bgautrea/coin_sorter/hardware/coin_hat/README.md

# Coin sorter HAT+ — rev 1

KiCad project for a Pi 5 HAT+ that carries the whole motion side of the
sorter: 12 V in, buck to 5 V for the Pi, a Raspberry Pi Pico, two StepStick
sockets (TMC2209 or A4988, selected by solder jumpers) for belt and feeder, the
MG996R diverter servo on its own buck, switched 12 V outputs, and the small
stuff (LED ring level shifter, feeder home switch, coin sensor, HAT+ ID EEPROM).

The board runs **lengthwise** along the Pi: 122 × 56.5 mm, the same width as the
Pi. The HAT+ holes and header sit at one end, and a 57 mm overhang runs past the
Pi's SD-card / PCIe end, so the drivers, jack and bucks sit over nothing. The
Pi + HAT stack is 142 × 56.5 mm, a slim box instead of rev 0's 85 × 90. The
overhang goes off the SD end, not the USB end: at 16 mm spacer height, a board
over the USB/Ethernet jacks would sit on top of the plugs.

Generated by a script, so it is a *netlist with symbols placed on a sheet*, not
a drawn schematic: every pin carries a global label and the parts are grouped by
function. Redraw with wires or leave it — KiCad is happy either way.

## Rev 1 changes (2026-09-27)

- **Diverter is the MG996R servo, not a stepper.** U4 socket, its jumpers
  JP41–44, the 4-pin motor connector and C5 are gone, and so is the diverter
  home switch (J8), because the servo is absolute. New parts: U8 is a separate
  12 V → 5–6 V buck just for the servo (+SERVO). J4 is a 3-pin 0.1" servo
  header (1 SIG, 2 V+, 3 GND). C6 is 1000 µF placed *at* J4. D5 lights when the
  servo rail is live, and GP27 reads the servo rail through a 10k/10k divider.
  GP6 drives the signal pin directly, with no series resistor and no pulldown.
  That is how the bench build works.
- **Why the LED and the sense line:** if the servo rail is dead and GP6 is
  pulsing, the servo back-powers through its signal pin. It twitches and never
  moves, which looks exactly like a signal fault. Check D5 (or GP27) first.
- **Outline goes lengthwise** (see above), with the **CSI/DSI FPC notch**
  (10 × 16.5 mm on the bottom edge, per the HAT+ spec's M.2 HAT+ drawing). Rev 0
  had no notch and would have blocked the camera cable.
- **Header position fixed.** Rev 0 had it 1.27 mm off in both axes. HAT+ spec:
  the header centre is 29 mm from the left hole, on the hole line, so pin 1 is
  at (8.37, 4.77) from the Pi corner and pin 2 is at (8.37, 2.23).
- **Diode polarity fixed.** KiCad diode and LED footprints put the cathode on
  pad 1, and rev 0's symbols had the anode on pin 1. D3/D4 flybacks would have
  shorted 12 V to ground when the key light or aux output switched on, D1
  would have blocked the Pico's VSYS, and D5 would never light.
- **StepStick pin numbering fixed.** Rev 0's symbol numbered pins 1 = EN …
  16 = GND. The `Pololu_Breakout-16` footprint is 1 = GND, 2 = VDD, 3–6 = motor,
  7 = GND, 8 = VMOT, 9 = EN … 16 = DIR, so every driver pin would have landed
  on the wrong pad.
- **Verified with KiCad 9:** ERC shows 0 errors (the remaining warnings are
  off-grid pins and the embedded `coin_hat` symbol library). Every symbol pin
  number exists as a pad on its footprint, and there are no single-node nets.
  DRC on the outline shows 0 violations. The floor plan on `User.Comments` is
  the real courtyards (buck modules as their 17.8 × 20.3 boards), checked for
  overlaps, holes, header and notch. 57 mm is the shortest overhang that packs
  cleanly; 52 mm clashes.

## Files

- `coin_hat.kicad_pro` / `coin_hat.kicad_sch` — open this. Symbols are embedded;
  footprints point at the stock KiCad 8 libraries. **Tools → Update PCB from
  Schematic** pulls all footprints into the board.
- `coin_hat.pretty/` + `fp-lib-table` — project footprint library with the
  two Pololu buck modules. Pad and mounting-hole positions come from Pololu's
  drill-guide DXFs (`reg15d01-drill.dxf` for the D24V50F5, `reg24g-drill.dxf`
  for the D36V28Fx), drawn top view with pad 1 = EN (square):
  - D24V50F5: one row EN, VIN, GND, GND, VOUT along a 0.7" edge.
  - D36V28Fx: the same row, plus PG 0.1" inboard of EN.
  - Both: #2 (2.2 mm) mounting holes in opposite corners.
  EN is left open on both (each module has a 100 kΩ pull-up to VIN), and PG
  is unused.
- `coin_hat.kicad_pcb` — placed and fully routed 2-layer board, 122 × 56.5 mm
  (see Routing).
- `make_fab.py` — regenerates everything in `fab/` from the schematic and board
  (`python3 hardware/coin_hat/make_fab.py`).
- `fab/` — ready to upload (see Ordering).

## Pin map (Pico)

| Function | Pins | Notes |
|---|---|---|
| Pi link | GP0 TX / GP1 RX (UART0) | Pi GPIO14/15, `/dev/ttyAMA0`, `dtparam=uart0=on`. REPL stays on USB. |
| Belt | STEP GP2, DIR GP3, EN GP4 | unchanged from `firmware/main.py`; TMC UART addr 0 |
| Diverter servo | GP6 → J4 signal | unchanged from `firmware/main.py`; direct, no resistors |
| Servo rail sense | GP27 (ADC1) | 10k / 10k: 5.4 V → 2.7 V, 6 V → 3.0 V |
| Feeder | STEP GP18, DIR GP19, EN GP22 | TMC UART addr 1 |
| TMC UART | GP20 TX via 1 k, GP21 RX | single-wire bus shared by both drivers |
| Feeder home | GP11 | to GND, internal pull-up |
| Coin sensor | GP5 | 3-pin XH |
| Key light / aux MOSFET | GP14 / GP15 | AO3400, flyback diode, 2-pin terminals |
| LED ring | GP16 → 74AHCT1G125 → 5 V data | 3-pin XH |
| VMOT sense | GP28 | 100 k / 15 k: 12 V → 1.57 V |
| Aux header | GP7, GP9, GP17, GP12/13 (I²C), GP26 (ADC0) | plus 3V3/GND |
| Spare | GP8, GP10 | no-connect |

The Pi resets the Pico by driving **GPIO17 high**, which makes Q3 pull RUN low.
It is active-high on purpose: GPIO17 defaults to pull-down at boot, so an
unconfigured Pi leaves the Pico running. `pinctrl set 17 op dh; sleep 0.1;
pinctrl set 17 dl` replaces the USB DTR toggle that relaunches `main.py` today.

## Power

Jack → F1 (mini blade) → +12 V bus. The bus feeds:

- the StepSticks (100 µF each) and the switched outputs;
- U5 (12 → 5 V, 5 A module) → +5 V → Pi header pins 2/4, and Pico VSYS
  through D1;
- U8 (12 → 5–6 V, ~3 A module) → +SERVO → J4.

U5 is a Pololu D24V50F5. For U8, any D36V28Fx fits the same footprint: the F5 (5 V) or the F6 (6 V). The MG996R
is rated 4.8–7.2 V, and 6 V gives more torque than the 5.4 V bench supply.

Feeding a Pi 5 over the header skips USB-PD, so set `usb_max_current_enable=1`
if USB peripherals need more than 600 mA. Size F1 to the real load: Pi 5 up to
~2.3 A at 12 V, plus two steppers, plus the servo (1.4 A stall at 6 V ≈ 0.8 A
at 12 V).

## Mechanical

- 16 mm board-to-board spacers (HAT+ spec recommendation for the Active
  Cooler) and a matching stacking header. Keep the bottom side clear over
  the Pi (Pico zone) and over the Pi 5 PoE header, which is marked on the
  board.
- The Pi 5 PCIe FFC connector sits under the overhang near the Pi edge. It is
  unused here, and a flat cable would still pass under a 16 mm-high board.
- The motor connectors, fuse and jack are on the left end so a case can have
  one connector wall. J5 is a CUI PJ-102AH (5 A, 5.5 × 2.1 plug).
- Copper keepouts around the four HAT+ holes: 3.1 mm radius on the bottom,
  where the metal standoff sits (and is likely tied to the Pi's ground), and
  2.6 mm on top, under the screw head.

## Routing

Two layers, 1 oz, every net routed. KiCad 9 DRC: 0 violations, 0 unconnected,
0 schematic-parity issues.

| Net class | Nets | Track |
|---|---|---|
| HighCurrent | VIN_RAW, +12V, +5V | 1.5 mm |
| Power | +SERVO, VSYS_PICO, switched 12 V outputs | 1.0 mm |
| Motor | stepper coil nets | 0.6 mm |
| Ground | GND (the pours carry the current) | 0.35 mm |
| Default | signals | 0.25 mm / 0.2 mm space |

Signal vias are 0.6/0.3 mm. Power-net vias are 1.2/0.6 mm (about 3 A each),
except one 0.8/0.4 mm AUX_SW via in a tight spot, so rate J12 (aux 12 V out) at
about 1.5 A. GND is poured on both layers. Five GND pads connect solid to the
pour rather than through thermal spokes: U3.7, J10.2, J1.14, C6.2 and one Pico
GND pad. Give those a hotter iron.

Freerouting did the autorouting, except for the Pi 5 V feed, which is
hand-placed and locked. J1 pins 2/4 are boxed in by the mounting hole, the board
edge and the other header pins, so the feed runs 1.5 mm on F.Cu from U5 VOUT,
passes under the hole, and necks to 1.0 mm for the last ~3 mm beside pin 1.
Official HAT+ boards squeeze through the same gap.

The Pico sits with its USB socket at the board's right edge, so a micro-USB
cable plugs in for REPL and `mpremote`. The HAT+ ID EEPROM group (U7,
R10–R12, JP1, C8) sits in the pocket left of the Pico. U6 and U7 each have a
100 nF bypass cap (C7, C8).

Silkscreen: labels for JLCPCB-placed parts are on F.Fab only (the placement
file carries them). JP21/22/23 and JP32/33 had no room for a readable label, so
read the jumper columns top to bottom: JP21→JP24 beside U2 (belt) and JP31→JP34
beside U3 (feeder). JP24, JP31 and JP34 are labelled, and the 2-pad MS1/MS2
jumpers sit above the 3-pad ones.

## Ordering

Everything is in `fab/`:

- `coin_hat_gerbers.zip` — Gerbers + Excellon drill (separate PTH/NPTH). Both
  fabs take it. Specs: 2 layers, 122 × 56.5 mm, 1.6 mm FR-4, 1 oz, smallest
  drill 0.3 mm, track/space 0.25/0.2 mm. Standard capabilities at both.
- **JLCPCB** — `jlcpcb/coin_hat_bom_jlcpcb.csv` + `jlcpcb/coin_hat_cpl_jlcpcb.csv`.
  Assembly: top side only, 25 placements, 12 unique parts. All resistors,
  the AO3400A and the SS34 are Basic parts. The SMBJ15A is "preferred
  extended" (no setup fee). The level shifter, EEPROM and LED are Extended
  (JLC's per-part loading fee).
- **PCBWay** — `pcbway/coin_hat_bom_pcbway.csv` (every part, with through-hole
  lines marked "customer solders") + `pcbway/coin_hat_centroid_pcbway.csv`.

Check before you pay:

- **JLCPCB's placement preview.** KiCad and JLC orient some packages
  differently. The CPL applies the usual corrections (SOT-23 / SC-70 +180°,
  SOIC +270°), but check every part, and especially the cathode bars on
  D1–D4 and the LED.
- U1 (Pico) and the solder jumpers are deliberately left out of assembly. The
  Pico's pads have no paste, so the stencil leaves them bare. You solder the
  Pico by its castellations. KiCad DRC reports U1 as "differs from library"
  for that reason. That warning is expected.
- Hand-soldered: J1 is a 2×20, 2.54 mm female socket on the **bottom** side.
  It is not in the BOMs, and its height matters. With 16 mm spacers, the Pi's
  pins (8.5 mm tall) only engage a socket body of H mm by H − 7.5 mm, so a
  standard 8.5 mm socket barely touches. Use an 11–13 mm tall socket. The
  StepStick sockets are 2× 1×8 female headers per driver.
- Trim through-hole leads flush over the Pi (J6/J7/J9–J12). The Active Cooler
  sits under that area, and the HAT+ spec asks for extra clearance if the
  underside isn't flat.
- Power only through the 12 V jack while the HAT is fitted. U5 feeds the Pi's
  5 V rail directly, with nothing to stop backfeed if the Pi's USB-C is also
  plugged in. U5 also regulates to 5.0 V, not the 5.1 V the Pi's own supply
  gives. That's fine, but it leaves less headroom before the under-voltage
  warning if a heavy USB load is attached.

## Verify before ordering

- TMC2209 breakout pin order (the 16-pin socket varies between makers; DIAG /
  INDEX are often extra pins outside it).
- Solder jumpers per driver socket (JPx1–JPx4) match the driver you fit:
  **TMC2209** — JPx3=A (UART on pin 4), JPx4=A (CLK→GND), JPx1/JPx2 = UART
  address (belt 00, feeder 10). **A4988** — JPx3=B (MS3 high), JPx4=B (RESET
  tied to SLEEP), JPx1+JPx2 closed = 1/16 step; set Vref = I × 8 × Rsense
  (0.40 V for 0.5 A with R100 sense resistors); heatsink.
- Buck modules sit on 0.1" header pins in the `coin_hat:Pololu_*` footprints.
  Order the modules with their header strip, or use a low-profile socket.
- J4 pin order vs your servo plug (usual order: signal, V+, GND; brown wire =
  GND).
- Header, holes and FPC notch against the official Pi 5 mechanical drawing. The
  socket goes on the **bottom** side.
- Belt motor current rating (TMC2209 tops out around 2 A RMS).

## Firmware implications

The feeder moves to DIR/EN on GP19/GP22, and the Pi link moves from USB CDC to
UART0. Current and hold settings move from DIP switches to TMC UART writes. The
servo stays on GP6 exactly as `firmware/main.py` drives it today; optionally
read GP27 and refuse to pulse GP6 while the servo rail is down. None of this
changes the serial protocol the Pi speaks.
