bgautrea/coin_sorter/hardware/coin_hat/coin_hat.kicad_pcb

## KiCad design hardware/coin_hat/coin_hat.kicad_pcb (2026-09-27)

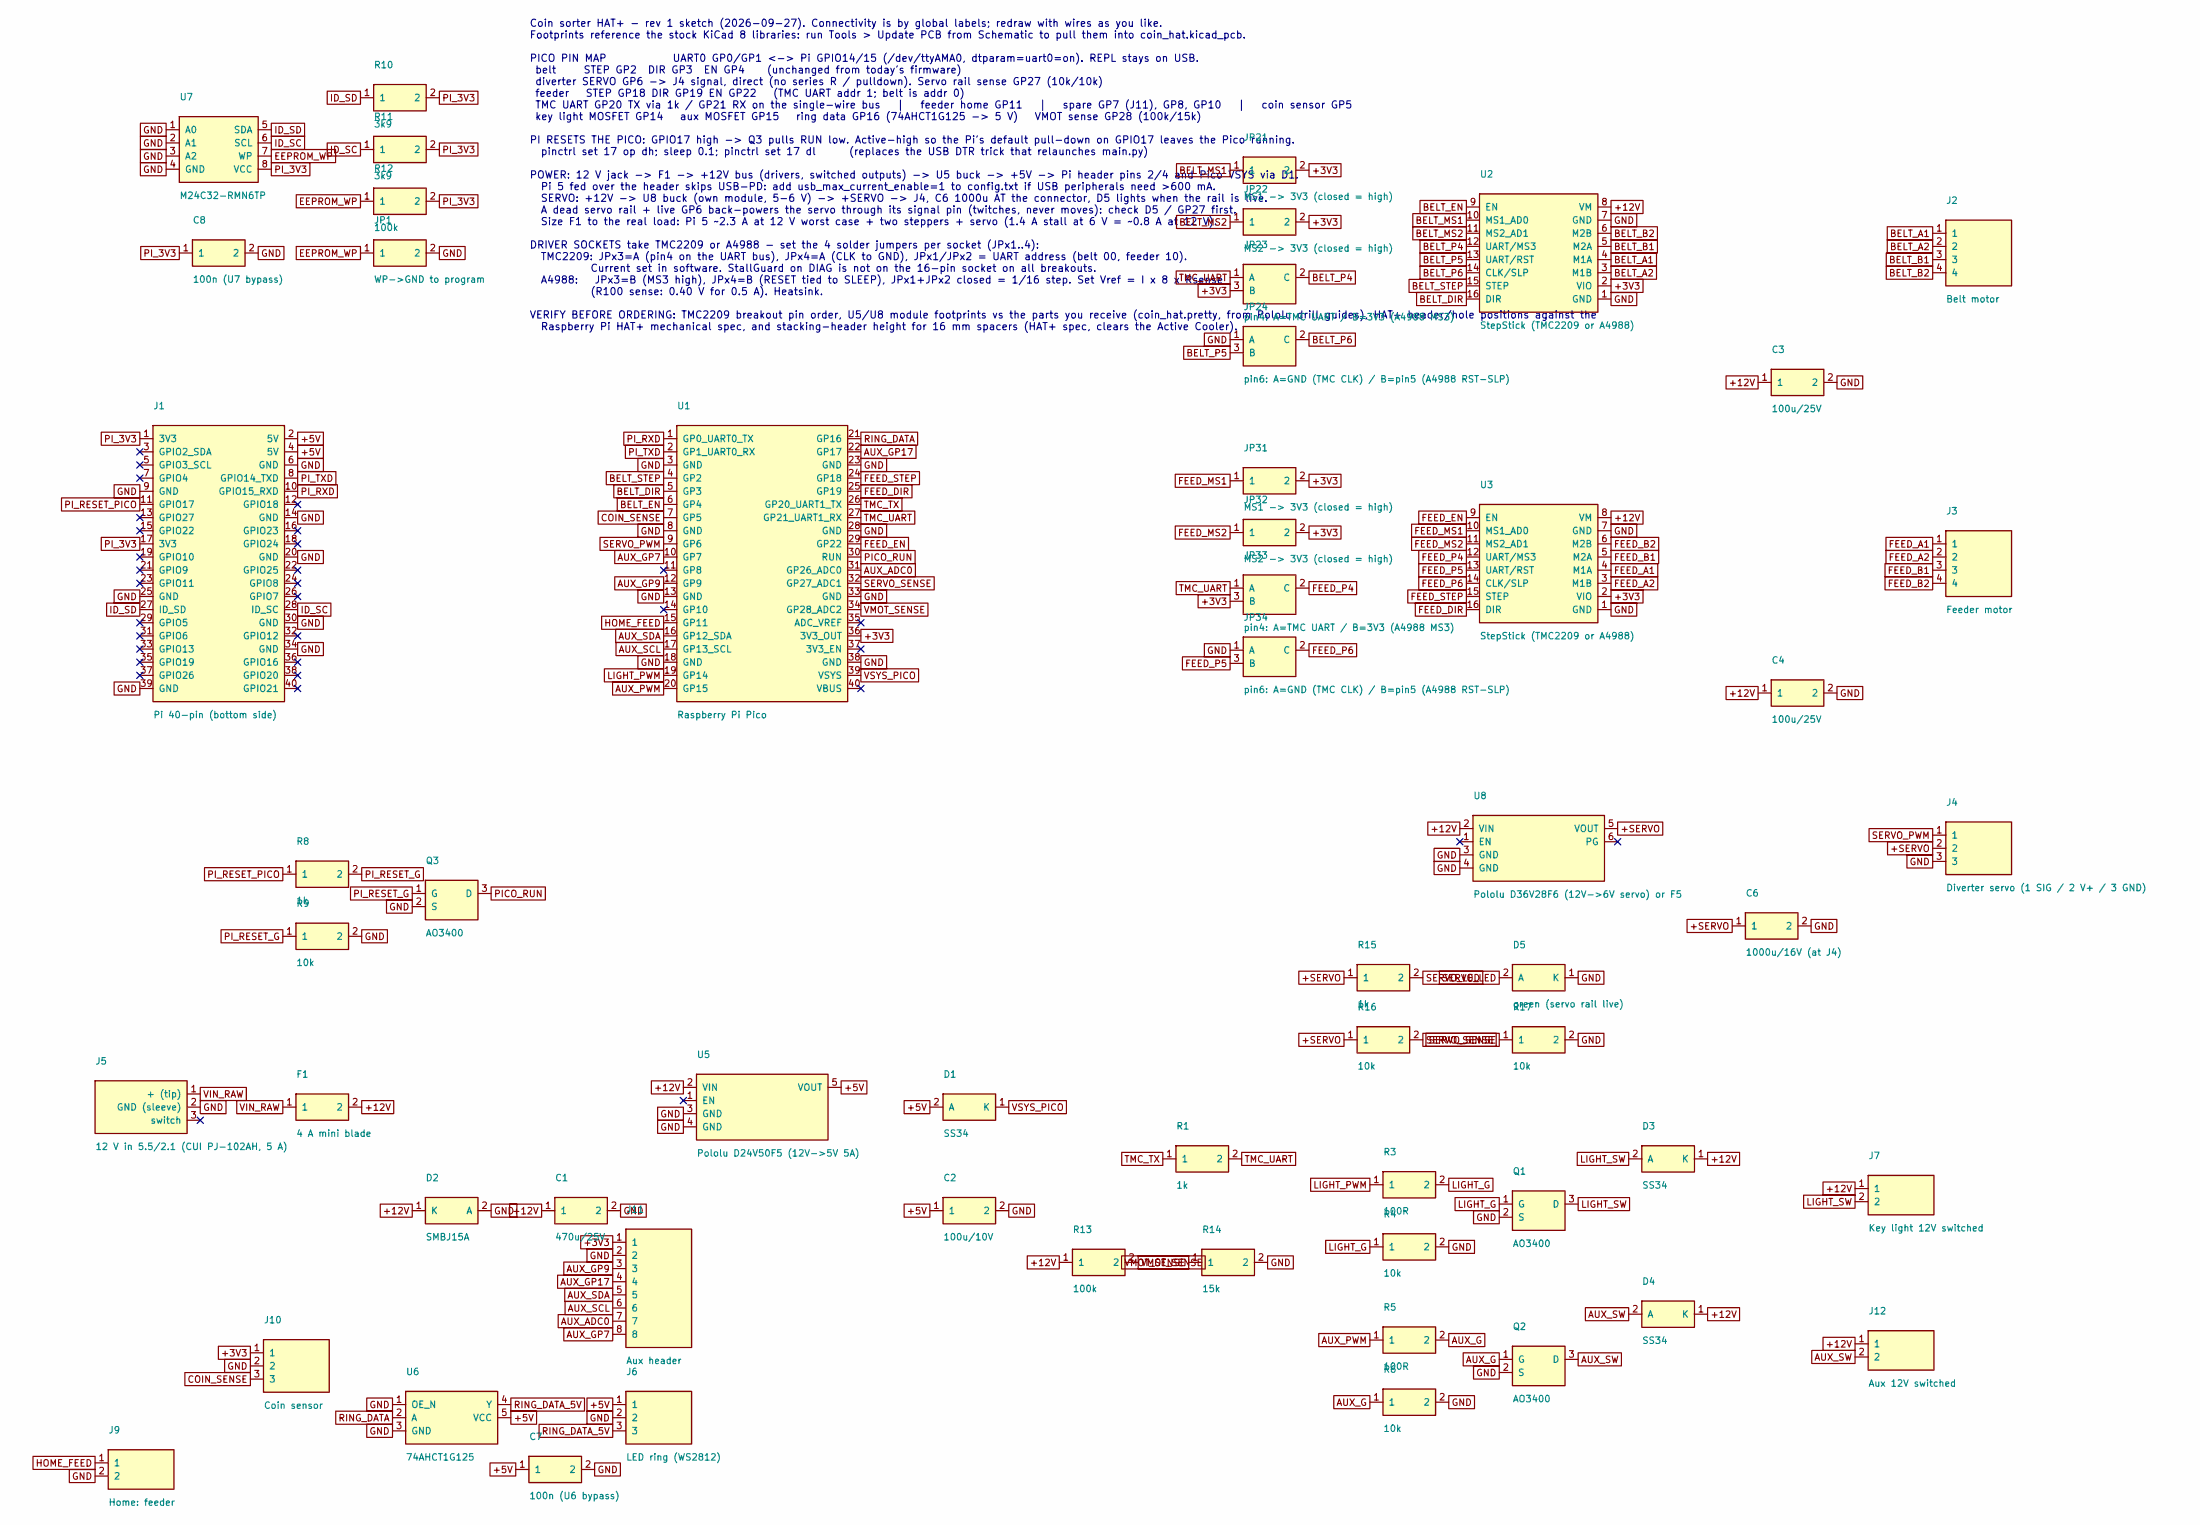
[picture p1: schematic coin_hat.kicad_sch, Coin sorter HAT+]

Parts:
C1: 470u/25V; CP_Radial_D10.0mm_P5.00mm
C2: 100u/10V; CP_Radial_D8.0mm_P3.50mm
C3, C4: 100u/25V; CP_Radial_D8.0mm_P3.50mm
C6: 1000u/16V (at J4); CP_Radial_D10.0mm_P5.00mm
C7: 100n (U6 bypass); C_0603_1608Metric; MPN CC0603KRX7R9BB104; LCSC C14663
C8: 100n (U7 bypass); C_0603_1608Metric; MPN CC0603KRX7R9BB104; LCSC C14663
D1, D3, D4: SS34; D_SMA; MPN SS34; LCSC C8678
D2: SMBJ15A; D_SMB; MPN SMBJ15A; LCSC C19077569
D5: green (servo rail live); LED_0603_1608Metric; MPN XL-1608UGC-04; LCSC C965804
F1: 4 A mini blade; Fuseholder_Blade_Mini_Keystone_3568; MPN 3568 holder + 4 A mini blade fuse
J1: Pi 40-pin (bottom side); PinSocket_2x20_P2.54mm_Vertical
J2: Belt motor; JST_XH_B4B-XH-A_1x04_P2.50mm_Vertical; MPN B4B-XH-A(LF)(SN); LCSC C144395
J3: Feeder motor; JST_XH_B4B-XH-A_1x04_P2.50mm_Vertical; MPN B4B-XH-A(LF)(SN); LCSC C144395
J4: Diverter servo (1 SIG / 2 V+ / 3 GND); PinHeader_1x03_P2.54mm_Vertical
J5: 12 V in 5.5/2.1 (CUI PJ-102AH, 5 A); BarrelJack_CUI_PJ-102AH_Horizontal; MPN PJ-102AH; LCSC C3096093
J6: LED ring (WS2812); JST_XH_B3B-XH-A_1x03_P2.50mm_Vertical; MPN B3B-XH-A(LF)(SN); LCSC C144394
J7: Key light 12V switched; JST_XH_B2B-XH-A_1x02_P2.50mm_Vertical; MPN B2B-XH-A(LF)(SN); LCSC C158012
J9: Home: feeder; JST_XH_B2B-XH-A_1x02_P2.50mm_Vertical; MPN B2B-XH-A(LF)(SN); LCSC C158012
J10: Coin sensor; JST_XH_B3B-XH-A_1x03_P2.50mm_Vertical; MPN B3B-XH-A(LF)(SN); LCSC C144394
J11: Aux header; PinHeader_1x08_P2.54mm_Vertical
J12: Aux 12V switched; JST_XH_B2B-XH-A_1x02_P2.50mm_Vertical; MPN B2B-XH-A(LF)(SN); LCSC C158012
JP1: WP->GND to program; SolderJumper-2_P1.3mm_Open_RoundedPad1.0x1.5mm
JP21, JP31: MS1 -> 3V3 (closed = high); SolderJumper-2_P1.3mm_Open_RoundedPad1.0x1.5mm
JP22, JP32: MS2 -> 3V3 (closed = high); SolderJumper-2_P1.3mm_Open_RoundedPad1.0x1.5mm
JP23, JP33: pin4: A=TMC UART / B=3V3 (A4988 MS3); SolderJumper-3_P1.3mm_Open_RoundedPad1.0x1.5mm
JP24, JP34: pin6: A=GND (TMC CLK) / B=pin5 (A4988 RST-SLP); SolderJumper-3_P1.3mm_Open_RoundedPad1.0x1.5mm
Q1, Q2, Q3: AO3400; SOT-23; MPN AO3400A; LCSC C20917
R1, R8, R15: 1k; R_0603_1608Metric; MPN 0603WAF1001T5E; LCSC C21190
R3, R5: 100R; R_0603_1608Metric; MPN 0603WAF1000T5E; LCSC C22775
R4, R6, R9, R16, R17: 10k; R_0603_1608Metric; MPN 0603WAF1002T5E; LCSC C25804
R10, R11: 3k9; R_0603_1608Metric; MPN 0603WAF3901T5E; LCSC C23018
R12, R13: 100k; R_0603_1608Metric; MPN 0603WAF1003T5E; LCSC C25803
R14: 15k; R_0603_1608Metric; MPN 0603WAF1502T5E; LCSC C22809
U1: Raspberry Pi Pico; RaspberryPi_Pico_SMD_HandSolder; MPN Raspberry Pi Pico (SC0915)
U2, U3: StepStick (TMC2209 or A4988); Pololu_Breakout-16_15.2x20.3mm
U5: Pololu D24V50F5 (12V->5V 5A); Pololu_D24V50F5; MPN D24V50F5 (#2851)
U6: 74AHCT1G125; SOT-353_SC-70-5; MPN SN74AHCT1G125DCKR; LCSC C350557
U7: M24C32-RMN6TP; SOIC-8_3.9x4.9mm_P1.27mm; MPN M24C32-RMN6TP; LCSC C79920
U8: Pololu D36V28F6 (12V->6V servo) or F5; Pololu_D36V28Fx; MPN D36V28F6 (#3783)

Connections:
+3V3: J10.1, J11.1, JP21.2, JP22.2, JP23.3 (B), JP31.2, JP32.2, JP33.3 (B), U1.36 (3V3_OUT), U2.2 (VIO), U3.2 (VIO)
+5V: C2.1, C7.1, D1.2 (A), J1.2 (5V), J1.4 (5V), J6.1, U5.5 (VOUT), U6.5 (VCC)
+12V: C1.1, C3.1, C4.1, D2.1 (K), D3.1 (K), D4.1 (K), F1.2, J7.1, J12.1, R13.1, U2.8 (VM), U3.8 (VM), U5.2 (VIN), U8.2 (VIN)
+SERVO: C6.1, J4.2, R15.1, R16.1, U8.5 (VOUT)
AUX_ADC0: J11.7, U1.31 (GP26_ADC0)
AUX_G: Q2.1 (G), R5.2, R6.1
AUX_GP7: J11.8, U1.10 (GP7)
AUX_GP9: J11.3, U1.12 (GP9)
AUX_GP17: J11.4, U1.22 (GP17)
AUX_PWM: R5.1, U1.20 (GP15)
AUX_SCL: J11.6, U1.17 (GP13_SCL)
AUX_SDA: J11.5, U1.16 (GP12_SDA)
AUX_SW: D4.2 (A), J12.2, Q2.3 (D)
BELT_A1: J2.1, U2.4 (M1A)
BELT_A2: J2.2, U2.3 (M1B)
BELT_B1: J2.3, U2.5 (M2A)
BELT_B2: J2.4, U2.6 (M2B)
BELT_DIR: U1.5 (GP3), U2.16 (DIR)
BELT_EN: U1.6 (GP4), U2.9 (EN)
BELT_MS1: JP21.1, U2.10 (MS1_AD0)
BELT_MS2: JP22.1, U2.11 (MS2_AD1)
BELT_P4: JP23.2 (C), U2.12 (UART/MS3)
BELT_P5: JP24.3 (B), U2.13 (UART/RST)
BELT_P6: JP24.2 (C), U2.14 (CLK/SLP)
BELT_STEP: U1.4 (GP2), U2.15 (STEP)
COIN_SENSE: J10.3, U1.7 (GP5)
EEPROM_WP: JP1.1, R12.1, U7.7 (WP)
FEED_A1: J3.1, U3.4 (M1A)
FEED_A2: J3.2, U3.3 (M1B)
FEED_B1: J3.3, U3.5 (M2A)
FEED_B2: J3.4, U3.6 (M2B)
FEED_DIR: U1.25 (GP19), U3.16 (DIR)
FEED_EN: U1.29 (GP22), U3.9 (EN)
FEED_MS1: JP31.1, U3.10 (MS1_AD0)
FEED_MS2: JP32.1, U3.11 (MS2_AD1)
FEED_P4: JP33.2 (C), U3.12 (UART/MS3)
FEED_P5: JP34.3 (B), U3.13 (UART/RST)
FEED_P6: JP34.2 (C), U3.14 (CLK/SLP)
FEED_STEP: U1.24 (GP18), U3.15 (STEP)
GND: C1.2, C2.2, C3.2, C4.2, C6.2, C7.2, C8.2, D2.2 (A), D5.1 (K), J1.6 (GND), J1.9 (GND), J1.14 (GND), J1.20 (GND), J1.25 (GND), J1.30 (GND), J1.34 (GND), J1.39 (GND), J4.3, J5.2 (GND (sleeve)), J6.2, J9.2, J10.2, J11.2, JP1.2, JP24.1 (A), JP34.1 (A), Q1.2 (S), Q2.2 (S), Q3.2 (S), R4.2, R6.2, R9.2, R14.2, R17.2, U1.3 (GND), U1.8 (GND), U1.13 (GND), U1.18 (GND), U1.23 (GND), U1.28 (GND), U1.33 (GND), U1.38 (GND), U2.1 (GND), U2.7 (GND), U3.1 (GND), U3.7 (GND), U5.3 (GND), U5.4 (GND), U6.1 (OE_N), U6.3 (GND), U7.1 (A0), U7.2 (A1), U7.3 (A2), U7.4 (GND), U8.3 (GND), U8.4 (GND)
HOME_FEED: J9.1, U1.15 (GP11)
ID_SC: J1.28 (ID_SC), R11.1, U7.6 (SCL)
ID_SD: J1.27 (ID_SD), R10.1, U7.5 (SDA)
LIGHT_G: Q1.1 (G), R3.2, R4.1
LIGHT_PWM: R3.1, U1.19 (GP14)
LIGHT_SW: D3.2 (A), J7.2, Q1.3 (D)
PICO_RUN: Q3.3 (D), U1.30 (RUN)
PI_3V3: C8.1, J1.1 (3V3), J1.17 (3V3), R10.2, R11.2, R12.2, U7.8 (VCC)
PI_RESET_G: Q3.1 (G), R8.2, R9.1
PI_RESET_PICO: J1.11 (GPIO17), R8.1
PI_RXD: J1.10 (GPIO15_RXD), U1.1 (GP0_UART0_TX)
PI_TXD: J1.8 (GPIO14_TXD), U1.2 (GP1_UART0_RX)
RING_DATA: U1.21 (GP16), U6.2 (A)
RING_DATA_5V: J6.3, U6.4 (Y)
SERVO_LED: D5.2 (A), R15.2
SERVO_PWM: J4.1, U1.9 (GP6)
SERVO_SENSE: R16.2, R17.1, U1.32 (GP27_ADC1)
TMC_TX: R1.1, U1.26 (GP20_UART1_TX)
TMC_UART: JP23.1 (A), JP33.1 (A), R1.2, U1.27 (GP21_UART1_RX)
VIN_RAW: F1.1, J5.1 (+ (tip))
VMOT_SENSE: R13.2, R14.1, U1.34 (GP28_ADC2)
VSYS_PICO: D1.1 (K), U1.39 (VSYS)

Notes on the sheet:
Coin sorter HAT+ - rev 1 sketch (2026-09-27). Connectivity is by global labels; redraw with wires as you like. Footprints reference the stock KiCad 8 libraries: run Tools > Update PCB from Schematic to pull them into coin_hat.kicad_pcb. PICO PIN MAP UART0 GP0/GP1 <-> Pi GPIO14/15 (/dev/ttyAMA0, dtp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

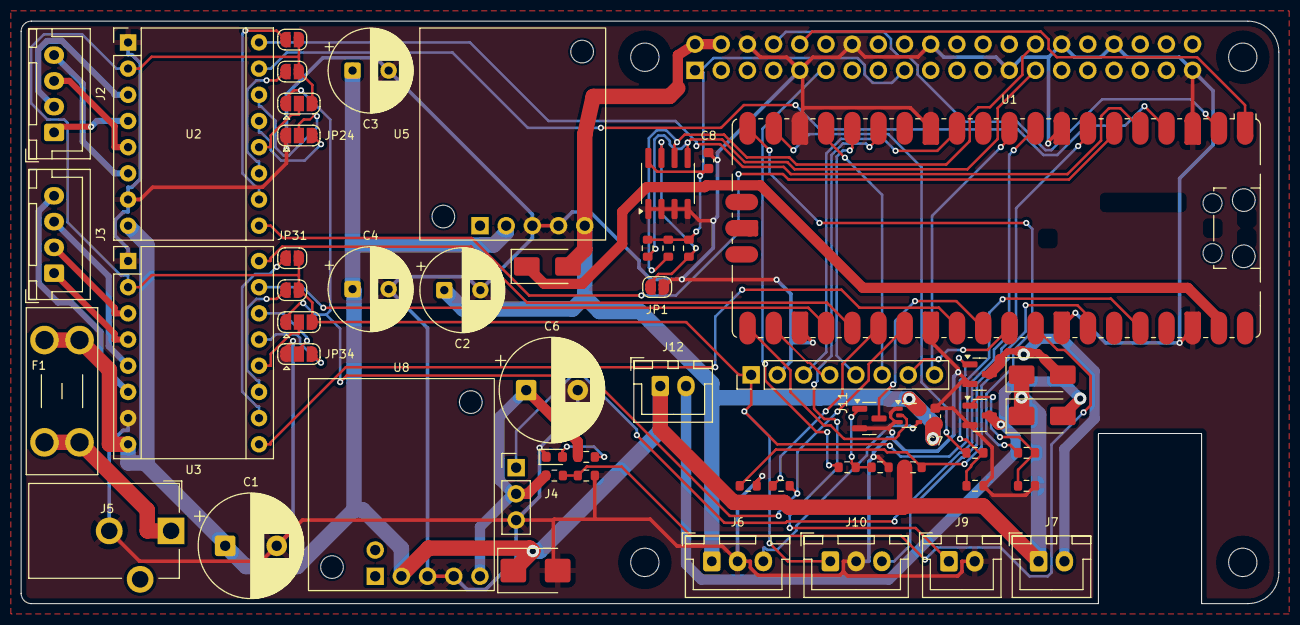
[picture p2: board coin_hat.kicad_pcb from above]

Board: 2 copper layers, 122.0 x 56.5 mm, 58 parts (1 on the bottom side), 62 nets.
