bgautrea/coin_sorter/firmware/main.py

# coin_sorter.py - RP2040 firmware
#
# Currently active hardware:
#   - Belt drive: NEMA17 via TB6600-style driver
#       PUL/DIR/ENA on GP2/3/4, driver + pins to Pico 3V3
#       Inverted ENA logic (this clone disables on current flow)
#   - Feeder drive: NEMA17 via TB6600-style driver (spins coins into the belt)
#       PUL/DIR/ENA on GP18/19/20, same wiring + inverted ENA as the belt
#
# Add later by flipping the flags below:
#   DIVERTER_ENABLED    - MG996R digital servo on GP6 (dish diverter)
#   HOME_SWITCH_ENABLED - microswitch on GP10
#   COIN_SENSOR_ENABLED - IR break-beam on GP11

import sys, select, time
from machine import Pin, PWM, mem32
from rp2 import PIO, StateMachine, asm_pio
from neopixel import NeoPixel

# Diverter servo signal: drive it LOW before anything else can take time.
# An undriven GP6 floats, and a digital servo (5 us dead band) chases the
# noise instead of sitting still - which looks exactly like a wiring fault.
Pin(6, Pin.OUT, value=0)

# ============================================================
# Feature flags - flip to True as you wire each subsystem
# ============================================================
DIVERTER_ENABLED    = True
HOME_SWITCH_ENABLED = False
COIN_SENSOR_ENABLED = False

# ============================================================
# Belt stepper (TB6600 / NEMA17)
# ============================================================
PUL = Pin(2, Pin.OUT, value=1)
DIR = Pin(3, Pin.OUT, value=0)
ENA = Pin(4, Pin.OUT, value=0)

# Bump GP2/3/4 to 12mA drive strength via PADS_BANK0
PADS_BASE = 0x4001C000
for _gpio in (2, 3, 4):
    _reg = PADS_BASE + 0x04 + _gpio * 4
    mem32[_reg] = (mem32[_reg] & ~0x30) | 0x30

# Driver enable bookkeeping. A TB6600 pushes its full DIP-set current through
# a stationary winding for as long as ENA is asserted, with no back-EMF to
# limit it -- that is the maximum-dissipation case and it cooked the feeder
# motor (125C measured) during pauses between bursts. Neither motor needs
# holding torque here, so the main loop releases ENA after IDLE_DISABLE_MS
# without motion. Motion commands re-enable on demand.
IDLE_DISABLE_MS = 1000
_drv = {"belt": False, "feeder": False}          # ENA asserted?
_idle_since = {"belt": 0, "feeder": 0}           # ticks_ms of last motion end

def belt_enable(on):
    """Inverted ENA logic for this driver clone."""
    ENA.value(1 if on else 0)
    _drv["belt"] = bool(on)
    _idle_since["belt"] = time.ticks_ms()

LED = Pin(25, Pin.OUT, value=0)

# ============================================================
# PIO step-pulse generator (continuous RUN / FRUN)
#
# machine.Timer callbacks are soft-scheduled Python on the rp2 port and top
# out around 1-2 kHz of toggles, so a Timer-driven square wave silently
# flat-lines well below the requested step rate. A PIO state machine emits
# an exact square wave at any frequency with zero CPU involvement, and each
# stepper gets its own SM so belt and feeder are fully independent.
# ============================================================
@asm_pio(set_init=PIO.OUT_HIGH)
def _step_wave():
    # 32 cycles low, 32 cycles high -> one step per 64 SM cycles. Pulse width
    # is >= 2.2us (TB6600 minimum) at every rate we can reach.
    set(pins, 0) [31]
    set(pins, 1) [31]

PIO_CYCLES_PER_STEP = 64
STEP_MIN_HZ   = 30      # SM clock floor (~1.9 kHz) / 64
RAMP_START_HZ = 400     # a stepper can start cold up to about here
RAMP_STEPS    = 25      # accel ramp resolution ...
RAMP_STEP_MS  = 10      # ... and duration (25 x 10ms = 250ms to target)

class StepGen:
    """Continuous step pulses on one PIO state machine."""
    def __init__(self, sm_id, gpio):
        self.gpio = gpio
        self.pin = Pin(gpio, Pin.OUT, value=1)
        self.sm = StateMachine(sm_id)
        self.hz = 0

    def _set(self, hz):
        self.sm.active(0)
        self.sm.init(_step_wave, freq=hz * PIO_CYCLES_PER_STEP, set_base=self.pin)
        self.sm.active(1)
        self.hz = hz

    def start(self, hz):
        """Run at `hz` steps/s (unsigned). Ramps up from the current rate so a
        cold start to a high rate doesn't stall the motor; slows instantly."""
        hz = max(STEP_MIN_HZ, int(hz))
        f0 = max(self.hz, RAMP_START_HZ)
        if hz > f0:
            for i in range(1, RAMP_STEPS + 1):
                self._set(f0 + (hz - f0) * i // RAMP_STEPS)
                time.sleep_ms(RAMP_STEP_MS)
        else:
            self._set(hz)
        return hz

    def stop(self):
        """Halt and hand the pin back to GPIO (idle high) for bit-bang moves."""
        self.sm.active(0)
        self.pin = Pin(self.gpio, Pin.OUT, value=1)
        self.hz = 0

belt_gen = StepGen(0, 2)

# ============================================================
# Feeder stepper (TB6600 / NEMA17) - spins coins onto the belt
# Same driver + wiring as the belt; its own pins and timer so it
# can free-run independently while the belt also runs.
# ============================================================
FPUL = Pin(18, Pin.OUT, value=1)
FDIR = Pin(19, Pin.OUT, value=0)
FENA = Pin(20, Pin.OUT, value=0)

for _gpio in (18, 19, 20):
    _reg = PADS_BASE + 0x04 + _gpio * 4
    mem32[_reg] = (mem32[_reg] & ~0x30) | 0x30

def feeder_enable(on):
    """Inverted ENA logic for this driver clone (matches the belt)."""
    FENA.value(1 if on else 0)
    _drv["feeder"] = bool(on)
    _idle_since["feeder"] = time.ticks_ms()

def idle_disable():
    """Release a driver that has sat enabled but motionless for IDLE_DISABLE_MS."""
    now = time.ticks_ms()
    if _drv["belt"] and not state["running"] and not state["busy"] \
            and time.ticks_diff(now, _idle_since["belt"]) > IDLE_DISABLE_MS:
        belt_enable(False)
    if _drv["feeder"] and not state["feeder_running"] and not state["busy"] \
            and time.ticks_diff(now, _idle_since["feeder"]) > IDLE_DISABLE_MS:
        feeder_enable(False)

feeder_gen = StepGen(1, 18)

# ============================================================
# Ring light (WS2812 on GP16) - camera illumination
# ============================================================
RING_PIN   = 16
RING_COUNT = 10
ring = NeoPixel(Pin(RING_PIN), RING_COUNT)  # GRB order, 800kHz

def ring_fill(r, g, b):
    """Set the whole ring to one colour (0-255 each) and latch it."""
    c = (r & 255, g & 255, b & 255)
    for i in range(RING_COUNT):
        ring[i] = c
    ring.write()

ring_fill(0, 0, 0)  # start dark

# ============================================================
# Diverter servo (MG996R digital, GP6) - optional
# ============================================================
# The dish is a fixed-tilt plate on a vertical axis: rotating it aims its one
# downhill direction at a bin. Nothing to home against - position is absolute
# pulse width. Deegoo-FPV MG996R: 500-2500 us = 0-180 deg (~11.1 us/deg),
# 5 us dead band. The axis is gravity-neutral, so holding torque is ~zero.
SERVO_PIN          = 6
SERVO_MIN_US       = 800     # clamps: keep well clear of the mechanical stops
SERVO_MAX_US       = 2200    # (bins sit at 900/2100, so there is trim room)
SERVO_RAMP_US      = 12      # per step while slewing (0 = jump straight there)
SERVO_RAMP_MS      = 6
SERVO_SETTLE_MS    = 300     # 0.14 s/60deg -> a full 110 deg move is ~260 ms
SERVO_DETACH_IDLE  = False   # True = stop pulses once settled (test first:
                             # digital servos may stay stiff, not go limp)

if DIVERTER_ENABLED:
    SERVO = PWM(Pin(SERVO_PIN))
    SERVO.freq(50)
else:
    SERVO = None

# Calibrated by eye with scripts/servo_jog.py, 2026-09-22.
#
# `recheck` is the CENTRE position on purpose. It is where the dish rests, so
# it is where a coin goes when nothing aimed the dish for it: one the detector
# never saw, one in a pile, one the gate rejected as a cluster. Those coins are
# unexamined, not common -- they must land in the pile that gets re-fed, never
# in the discard. Sorting into the wrong keep pile is a nuisance; sorting an
# unexamined coin into the discard pile loses it.
BIN_POSITIONS = {
    "keep":     900,   # near side  - what you are hunting for
    "recheck": 1500,   # straight ahead - DEFAULT: unseen, unsure, piled
    "reject":  2100,   # far side   - confidently identified, discard
}
# Older configs said common/check. Accept both so a stale config.local.yaml
# fails visibly at the map, not silently at the dish.
BIN_ALIASES = {"common": "reject", "check": "recheck"}

if DIVERTER_ENABLED:
    # Park at the default on boot: a fresh PWM has duty 0 (pin low, no pulses),
    # so without this the dish would sit wherever it was left.
    SERVO.duty_ns(BIN_POSITIONS["recheck"] * 1000)

BELT_STEPS_PER_COIN = 400
# With the belt free-running (RUN) the Pi gates on coins crossing a trip line,
# so SORT must only aim the diverter. Advancing the belt here would also halt
# the free-run (a finite move and RUN cannot share PUL), stalling the feed.
SORT_ADVANCES_BELT = False

# ============================================================
# Optional sensors and outputs
# ============================================================
HOME_SW     = Pin(10, Pin.IN, Pin.PULL_UP) if HOME_SWITCH_ENABLED else None
COIN_SENSOR = Pin(11, Pin.IN, Pin.PULL_UP) if COIN_SENSOR_ENABLED else None
ACT         = Pin(15, Pin.OUT, value=0)   # legacy actuator output

# ============================================================
# State
# ============================================================
state = {
    "speed_hz": 1500,
    "busy": False,
    "belt_position": 0,
    "div_position": 1500,   # servo pulse width in us

    "homed": True,                      # servo is absolute - nothing to home
    "running": False,                   # True while the belt free-runs (RUN)
    "feeder_speed_hz": 1500,
    "feeder_running": False,            # True while the feeder free-runs (FRUN)
    "feeder_position": 0,
}

# ============================================================
# Belt motion
# ============================================================
def belt_move(steps):
    """Blocking belt move. Negative steps = reverse."""
    belt_stop()  # a finite move and a free-run must not fight over PUL
    direction = 1 if steps >= 0 else 0
    DIR.value(direction)
    time.sleep_us(5)
    belt_enable(True)
    half_us = max(50, 500_000 // state["speed_hz"])
    state["busy"] = True
    LED.on()
    for _ in range(abs(steps)):
        PUL.value(0); time.sleep_us(half_us)
        PUL.value(1); time.sleep_us(half_us)
        state["belt_position"] += 1 if direction else -1
    state["busy"] = False
    LED.off()
    _idle_since["belt"] = time.ticks_ms()

def belt_run(hz):
    """Start non-blocking continuous belt motion. hz>0 forward, hz<0 reverse.

    Returns the signed step rate actually applied. PIO drives PUL in the
    background, so the command loop stays responsive (STATUS/STOP work
    mid-run). STOP, MOVE or SORT halt it. belt_position is not tracked while
    free-running.
    """
    hz = int(hz)
    if hz == 0:
        belt_stop()
        return 0
    fwd = hz > 0
    if state["running"] and DIR.value() != (1 if fwd else 0):
        belt_stop()  # direction flip: come to rest before reversing
    DIR.value(1 if fwd else 0)
    belt_enable(True)
    state["running"] = True
    state["busy"] = True
    LED.on()
    state["speed_hz"] = belt_gen.start(abs(hz))
    return state["speed_hz"] if fwd else -state["speed_hz"]

def belt_stop():
    """Halt continuous belt motion (no-op if not running). Leaves PUL idle."""
    belt_gen.stop()
    _idle_since["belt"] = time.ticks_ms()
    if state["running"]:
        state["running"] = False
        state["busy"] = False
        LED.off()

# ============================================================
# Feeder motion (mirrors the belt, independent pins + timer)
# ============================================================
def feeder_move(steps):
    """Blocking feeder move. Negative steps = reverse."""
    feeder_stop()  # a finite move and a free-run must not fight over FPUL
    direction = 1 if steps >= 0 else 0
    FDIR.value(direction)
    time.sleep_us(5)
    feeder_enable(True)
    half_us = max(50, 500_000 // state["feeder_speed_hz"])
    state["busy"] = True
    for _ in range(abs(steps)):
        FPUL.value(0); time.sleep_us(half_us)
        FPUL.value(1); time.sleep_us(half_us)
        state["feeder_position"] += 1 if direction else -1
    state["busy"] = False
    _idle_since["feeder"] = time.ticks_ms()

def feeder_run(hz):
    """Start non-blocking continuous feeder motion. hz>0 fwd, hz<0 rev.

    Own PIO state machine, so it free-runs independently of the belt.
    Returns the signed step rate actually applied.
    """
    hz = int(hz)
    if hz == 0:
        feeder_stop()
        return 0
    fwd = hz > 0
    if state["feeder_running"] and FDIR.value() != (1 if fwd else 0):
        feeder_stop()  # direction flip: come to rest before reversing
    FDIR.value(1 if fwd else 0)
    feeder_enable(True)
    state["feeder_running"] = True
    state["feeder_speed_hz"] = feeder_gen.start(abs(hz))
    return state["feeder_speed_hz"] if fwd else -state["feeder_speed_hz"]

def feeder_stop():
    """Halt continuous feeder motion (no-op if not running). Leaves FPUL idle."""
    feeder_gen.stop()
    _idle_since["feeder"] = time.ticks_ms()
    if state["feeder_running"]:
        state["feeder_running"] = False

# ============================================================
# Diverter motion (no-ops when disabled)
# ============================================================
def div_write_us(us):
    if not DIVERTER_ENABLED: return
    us = max(SERVO_MIN_US, min(SERVO_MAX_US, int(us)))
    SERVO.duty_ns(us * 1000)
    state["div_position"] = us
    return us

def div_move_to(us, ramp=True):
    """Slew to an absolute pulse width, then wait for the servo to arrive."""
    if not DIVERTER_ENABLED: return
    target = max(SERVO_MIN_US, min(SERVO_MAX_US, int(us)))
    cur = state["div_position"]
    if SERVO is None or SERVO.duty_ns() == 0:   # re-attach after a detach
        div_attach()
    state["busy"] = True
    if ramp and SERVO_RAMP_US and cur != target:
        step = SERVO_RAMP_US if target > cur else -SERVO_RAMP_US
        for v in range(cur, target, step):
            div_write_us(v)
            time.sleep_ms(SERVO_RAMP_MS)
    div_write_us(target)
    time.sleep_ms(SERVO_SETTLE_MS)
    state["busy"] = False
    return target

def div_move(delta_us):
    if not DIVERTER_ENABLED: return
    return div_move_to(state["div_position"] + int(delta_us))

def div_attach():
    """Re-establish the pulse train after div_release()."""
    global SERVO
    if not DIVERTER_ENABLED: return
    SERVO = PWM(Pin(SERVO_PIN))
    SERVO.freq(50)
    SERVO.duty_ns(state["div_position"] * 1000)

def div_release():
    """Stop pulses and hold GP6 low - never leave the pin floating."""
    global SERVO
    if not DIVERTER_ENABLED or not SERVO_DETACH_IDLE: return
    SERVO.deinit()
    SERVO = None
    Pin(SERVO_PIN, Pin.OUT, value=0)

def div_home(timeout_steps=0):
    """No homing needed - the servo is absolute. Park at 'common'."""
    if not DIVERTER_ENABLED:
        state["homed"] = True
        return True
    div_move_to(BIN_POSITIONS["common"])
    state["homed"] = True
    return True

# ============================================================
# Coin sensor
# ============================================================
def coin_present():
    if not COIN_SENSOR_ENABLED:
        return False
    return COIN_SENSOR.value() == 0

def wait_for_coin(timeout_ms=10000):
    if not COIN_SENSOR_ENABLED:
        return False
    deadline = time.ticks_add(time.ticks_ms(), timeout_ms)
    while time.ticks_diff(deadline, time.ticks_ms()) > 0:
        if coin_present():
            return True
        time.sleep_ms(5)
    return False

# ============================================================
# Legacy actuator
# ============================================================
def fire(ms):
    ACT.value(1); time.sleep_ms(ms); ACT.value(0)

# ============================================================
# High-level sort
# ============================================================
def sort_coin(bin_name):
    bin_name = BIN_ALIASES.get(bin_name, bin_name)
    if bin_name not in BIN_POSITIONS:
        return f"ERR unknown bin: {bin_name}"
    if not state["homed"]:
        return "ERR not homed - send HOME first"
    if DIVERTER_ENABLED:
        # Pre-position BEFORE the coin tips off the roller nose.
        div_move_to(BIN_POSITIONS[bin_name])
    if SORT_ADVANCES_BELT:
        belt_move(BELT_STEPS_PER_COIN)
        time.sleep_ms(200)
    if DIVERTER_ENABLED:
        div_release()
    return f"OK sorted {bin_name}"

# ============================================================
# Command handler
# ============================================================
def handle(line):
    parts = line.strip().split()
    if not parts:
        return
    cmd = parts[0].upper()
    try:
        if cmd == "PING":
            print("OK PONG")
        elif cmd == "STATUS":
            features = "belt"
            if DIVERTER_ENABLED:    features += ",diverter"
            if HOME_SWITCH_ENABLED: features += ",home_sw"
            if COIN_SENSOR_ENABLED: features += ",coin_sensor"
            print(f"STATUS busy={state['busy']} running={state['running']} belt={state['belt_position']} feeder={state['feeder_position']} feeder_running={state['feeder_running']} div={state['div_position']} homed={state['homed']} speed={state['speed_hz']} feeder_speed={state['feeder_speed_hz']} belt_ena={_drv['belt']} feeder_ena={_drv['feeder']} coin={coin_present()} features={features}")
        elif cmd == "BINS":
            print("OK " + ",".join(f"{k}={v}" for k, v in BIN_POSITIONS.items()))
        # Belt
        elif cmd == "MOVE":
            belt_move(int(parts[1]))
            print(f"OK {state['belt_position']}")
        elif cmd == "RUN":
            hz = int(parts[1]) if len(parts) > 1 else state["speed_hz"]
            print(f"OK running {belt_run(hz)}")
        elif cmd == "STOP":
            belt_stop(); print("OK stopped")
        elif cmd == "SPEED":
            state["speed_hz"] = int(parts[1])
            print("OK")
        elif cmd == "ENABLE":
            belt_enable(True); print("OK")
        elif cmd == "DISABLE":
            belt_enable(False); print("OK")
        # Feeder
        elif cmd == "FMOVE":
            feeder_move(int(parts[1]))
            print(f"OK {state['feeder_position']}")
        elif cmd == "FRUN":
            hz = int(parts[1]) if len(parts) > 1 else state["feeder_speed_hz"]
            print(f"OK feeder running {feeder_run(hz)}")
        elif cmd == "FSTOP":
            feeder_stop(); print("OK feeder stopped")
        elif cmd == "FSPEED":
            state["feeder_speed_hz"] = int(parts[1])
            print("OK")
        elif cmd == "FENABLE":
            feeder_enable(True); print("OK")
        elif cmd == "FDISABLE":
            feeder_enable(False); print("OK")
        # Ring light
        elif cmd == "LED":
            r, g, b = int(parts[1]), int(parts[2]), int(parts[3])
            ring_fill(r, g, b)
            print(f"OK led {r & 255} {g & 255} {b & 255}")
        elif cmd == "RING":
            v = int(parts[1]) & 255
            ring_fill(v, v, v)
            print(f"OK ring {v}")
        # Diverter
        elif cmd == "DIV":
            div_move(int(parts[1])); div_release()
            print(f"OK {state['div_position']}")
        elif cmd == "DIVTO" or cmd == "SERVO":
            div_move_to(int(parts[1])); div_release()
            print(f"OK {state['div_position']}")
        elif cmd == "HOME":
            print("OK homed" if div_home() else "ERR home timeout")
        elif cmd == "SORT":
            print(sort_coin(parts[1].lower()))
        # Sensors / misc
        elif cmd == "WAIT":
            ms = int(parts[1]) if len(parts) > 1 else 10000
            print("OK seen" if wait_for_coin(ms) else "ERR no coin")
        elif cmd == "ACT":
            fire(int(parts[1])); print("OK")
        else:
            print(f"ERR unknown: {cmd}")
    except Exception as e:
        print(f"ERR {e}")

# ============================================================
# Main loop
# ============================================================
poller = select.poll()
poller.register(sys.stdin, select.POLLIN)
print("READY")
buf = ""
while True:
    idle_disable()
    if poller.poll(10):
        ch = sys.stdin.read(1)
        if ch == "\n":
            handle(buf)
            buf = ""
        else:
            buf += ch
