bgautrea/coin_sorter/(commit log)

2026-05-17 Initial scaffolding for coin sorter CV pipeline
    Pi-side runtime (picamera2 + OpenCV + onnxruntime + pyserial), Colab-side
    training notebook (Ultralytics YOLO-cls → ONNX export to Drive), and the
    glue between them: config, helper scripts, stub modules, smoke tests.
2026-06-09 Add belt-fed coin-presence gating to capture.py
    Capture previously saved full frames at a fixed interval, which on a moving
    belt yields mostly empty-belt frames mislabeled as coins, plus tiny coins once
    squashed to 224x224. Enhance capture for belt-fed data collection:
    - ROI crop to the belt region (camera.roi)
    - coin-presence gate via per-frame intensity segmentation (Otsu/threshold +
    area-fraction + circularity), which is motion-invariant on a moving belt
    where frame-differencing would fire everywhere; absdiff is a fallback
    - dedup so one physical coin yields one saved image (centroid-band trip line),
    with min_interval / none modes
    - tight square crop around the coin so it fills the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
    [capture.py, config.yaml]
2026-06-09 Add non-blocking belt RUN/STOP and wire it into capture
    The Pico firmware only had a blocking MOVE (busy-loop step pulses, replies OK
    only after completion) and no free-run command, so the previous --drive-belt
    (repeated finite MOVE chunks) could not actually run the belt while capturing —
    Pico.move() waits for a response that doesn't arrive until the move finishes,
    which also exceeds the serial read timeout for any move over ~1s.
    Firmware (now version-controlled at firmware/main.py, dumped from the device):
    - Add RUN <hz> / STOP: a hardware Timer drives PUL in the background so the
    belt runs continuously and the command loop stays responsive (STATUS/STOP
    work mid-run). hz sign sets d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
    [capture.py, config.yaml, main.py, pico.py, read_pico_program.py]
2026-06-09 Add WS2812 ring light control (Pico GP16) and wire into capture
    Even, consistent illumination is needed for usable training frames (the first
    calibration snapshot was dark). Add a 14-LED WS2812 ring driven by the Pico.
    Firmware (firmware/main.py): NeoPixel on GP16 (GRB, 14 px); LED <r> <g> <b> and
    RING <brightness> commands; ring starts dark. Verified on hardware (module
    loads, commands light the ring).
    Pi side:
    - pico.py: Pico.set_leds(r,g,b) / Pico.ring(brightness).
    - capture.py: maybe_open_belt -> maybe_open_pico, which turns the ring on for
    every capture AND calibration session (so calibration matches capture
    lighting) and off on exit; --lights/--no-lights and capture.lights/light_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
2026-06-09 Set ring LED count to 10 to match installed strip
    Replacement WS2812 ring has 10 LEDs (the original 14-LED strip was destroyed
    by a buck converter mis-set to 12V). RING_COUNT now matches the hardware.
    Re-flashed and hash-verified on the new Pico.
    [main.py]
2026-06-09 Drive Arducam 64MP autofocus (libcamera AfMode via picamera2)
    The 64MP module is an autofocus lens, and capture/sorter never set a focus
    mode, so frames were blurry. Mirror what cam_test/stream.py does with
    rpicam-vid (--autofocus-mode), using the picamera2 equivalent.
    - apply_autofocus(): set AfMode manual (locked LensPosition in dioptres) /
    auto (one-shot) / continuous; failures logged and swallowed.
    - camera.af_mode + camera.lens_position config; threaded through _open_camera
    in capture.py and sorter.py.
    Verified on hardware: continuous AF yields a sharp, readable penny under the
    ring light (was previously dark and out of focus).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
    [capture.py, config.yaml, sorter.py]
2026-06-10 Add web calibration + capture UI and manual white balance
    The rig is headless, so tuning focus/WB/ROI/thresholds via snapshot round-trips
    was painful, and auto-WB casts a magenta tint under the WS2812 ring (muddies the
    copper-vs-silver cue the classifier needs).
    - capture.py: apply_white_balance() (AwbEnable/ColourGains via libcamera);
    camera.awb + camera.colour_gains config threaded through capture/sorter, same
    shape as the autofocus support.
    - webcal.py (new): stdlib http.server app that owns the camera + Pico and streams
    a live MJPEG preview with the coin-detection overlay. Sliders for focus, white
    balance, ROI and gate thresholds; belt-fed capture of labelled data from the
    bro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
2026-06-10 Add belt reverse (Fwd/Rev toggle) to the web UI
    The firmware already runs the belt backward via a negative RUN value, so this is
    just a UI control: a Fwd/Rev button that flips the sign of the speed sent to
    RUN. Verified on hardware (RUN -200 spins the belt in reverse).
    [webcal.py]
2026-06-10 Add manual exposure + gain control (shutter slider) to freeze motion blur
    Locked focus alone doesn't stop blur while the belt moves — a long auto-exposure
    smears the moving belt/coins. Add a fast-shutter option (the bright ring light
    makes it feasible).
    - capture.py: apply_exposure() (AeEnable/ExposureTime/AnalogueGain); the existing
    camera.exposure_us/analogue_gain config is now actually applied, threaded
    through capture/sorter alongside focus/WB.
    - webcal.py: Exposure section (Auto + shutter-us + gain sliders), live-applied;
    exposure shown in the overlay HUD and emitted in the config snippet.
    Verified on hardware: setting exp=1500us gain=4 applies live (visibly darker
    frame, log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
    [capture.py, sorter.py, webcal.py]
2026-06-10 Cache absdiff background instead of recomputing the median every frame
    The absdiff presence-gate recomputed np.median over the entire bg_window
    stack on every frame, dropping the capture/preview stream from ~30 fps to
    ~3.8 fps. The background (static specular streak + belt) barely changes, so
    cache the median and refresh it only every `bg_refresh` frames (default =
    bg_window). Restores ~18 fps with no change in detection behaviour.
    Adds a documented `capture.bg_refresh` config key.
2026-06-21 Add coin-feeder stepper control (firmware + host + web UI)
    A second NEMA17 on a TB6600-style driver spins coins onto the belt,
    wired like the belt (PUL/DIR/ENA on GP18/19/20, inverted ENA). Drive it
    from its own hardware timer so it can free-run alongside the belt.
    - firmware: F* commands (FMOVE/FRUN/FSTOP/FSPEED/FENABLE/FDISABLE),
    independent feeder_timer, STATUS reports feeder position/run state.
    - pico.py: feeder_move/feeder_speed/feeder_run/feeder_stop wrappers.
    - webcal: Feeder panel (Run/Stop, Fwd/Rev, speed slider to 5000 Hz),
    state push via _apply_hw, feeder halted on shutdown.
    [main.py, pico.py, webcal.py]
2026-09-17 Drive belt/feeder free-run from PIO instead of machine.Timer
    The Timer-driven square wave was a soft-scheduled Python callback at
    2x the step rate, which saturates around 1-2 kHz of toggles on the rp2
    port -- so the feeder flat-lined far below the requested rate (and got
    worse with the belt timer also running). A PIO state machine emits an
    exact square wave at any frequency with zero CPU cost.
    - firmware: StepGen class (2-instruction PIO program clocked at 64x hz);
    belt on SM0/GP2, feeder on SM1/GP18, fully independent. Ramps from
    400 Hz to target over 250 ms on speed-ups so a cold start doesn't
    stall the motor; slows instantly. Hands the pin back to GPIO on stop
    so the blocking MOV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
    [main.py, webcal.py]
2026-09-17 Pin tuned belt (550 Hz) and feeder (8650 Hz) speeds in config
    Values found in the webcal tuning pass after the PIO step-generator fix:
    the feeder reliably ejects one coin at a time at 8650 Hz and 550 Hz on
    the belt keeps coins in frame without blur at the 1500us shutter. Adds
    capture.feeder_speed_hz, which webcal previously fell back to 400 for.
    [config.yaml]
2026-09-17 Harden the single-coin gate and add feeder pulsing
    Reviewing the nickel captures showed the detector saving clusters and
    edge-cut coins under the class label: max_area_frac 0.60 admits an
    8-coin blob, and circularity 0.65 passes two overlapping coins. Pennies
    have the same problem (only 59/163 clean).
    capture.py: _pick_blob now also requires
    - fill (area / min-enclosing-circle area) >= min_fill_frac: one coin
    ~0.95, two overlapping ~0.6 — far more decisive than circularity;
    - the blob not touching the ROI border (reject_border);
    - no other blob above isolate_min_frac inside the padded crop window
    (isolate), so a neighbour can't ride along in the saved crop.
    Detection gains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
    [capture.py, config.yaml, prune_crops.py, webcal.py]
2026-09-17 Auto-release stepper drivers after 1 s idle (feeder overheated to 125C)
    Nothing ever de-asserted ENA after a stop, so the TB6600 held its full
    DIP-set current through a stationary winding during every pause -- the
    maximum-dissipation case (no back-EMF). The feeder motor hit 257F/125C
    during pulsed feeding. Neither motor needs holding torque, so the main
    loop now releases ENA IDLE_DISABLE_MS (1 s) after motion ends on either
    axis; motion commands re-enable on demand. STATUS reports belt_ena /
    feeder_ena so it can be checked from the host.
    [main.py]
2026-09-17 Show applied sensor exposure/gain/WB/lux on the overlay; raise max_area for quarters and halves
    The camera loop reads capture_metadata() every 10th frame and publishes
    ExposureTime / AnalogueGain / ColourGains / Lux in /status and on the
    preview, so auto's pick can be locked as a manual recipe and the light
    level is visible while adjusting the lamp.
    Measured on the rig today: ~22 px/mm (nickel = 0.18 of the frame), so a
    quarter is ~0.24 and a half ~0.38 -- max_area_frac 0.20 would reject
    them. 0.45 now; fill/isolation reject clusters, not area.
    Claude-Session: https://claude.ai/code/session_01F7NoVCwbaSiu52WeHs72Ao
2026-09-18 webcal: gallery label dropdown with folder counts, and a Recipe button
    - Captures panel: the label is a <select> of every capture folder on disk
    (with counts) plus configured labels not yet on disk, refreshed after
    each Tag session. Mis-tags show up as unexpected counts. /folders.
    - Camera panel: "Recipe" restores the calibrated focus / WB / exposure
    loaded from config (config.local.yaml on the rig) after an Auto button
    or slider nudge -- the Auto modes are for finding a recipe, not for
    capture, and auto exposure runs the shutter out to 67 ms in dim light.
    Claude-Session: https://claude.ai/code/session_01F7NoVCwbaS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
2026-09-18 Add KiCad rev 0 sketch for a Pi 5 HAT+ (Pico + 3x TMC2209 + 12V in)
    Generated starting point under hardware/coin_hat: schematic with embedded
    symbols and stock-library footprints, HAT+ board outline with hole pattern
    and placement zones, and a README with the Pico pin map.
    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
    [coin_hat.kicad_pcb, coin_hat.kicad_sch]
2026-09-19 coin_hat: driver sockets accept TMC2209 or A4988 via solder jumpers
    Pins 4/5/6 of each StepStick socket were hard-wired for the TMC2209
    (UART/UART/CLK->GND), which would hold an A4988 in SLEEP and leave MS3
    on the UART bus. Add four solder jumpers per socket (MS1, MS2, pin4
    UART-or-3V3, pin6 GND-or-pin5) and document both settings.
    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
    [coin_hat.kicad_pcb, coin_hat.kicad_sch]
2026-09-19 coin_hat: fix footprint names that don't resolve (Pico, 12V terminal blocks)
    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
    [coin_hat.kicad_pcb, coin_hat.kicad_sch]
2026-09-24 Diverter: MG996R servo on GP6 replaces the 28BYJ-48 stepper
    The diverter is now a fixed-tilt dish on a vertical servo axis: rotating it
    aims its one downhill direction at a bin. Position is absolute pulse width,
    so there is nothing to home against and div_home() just parks at `common`.
    BIN_POSITIONS becomes microseconds and finally matches the bin names
    sorter.py actually sends (keep/common/check). It previously held stepper
    counts keyed penny/nickel/dime/quarter/reject, so every SORT would have
    failed with "unknown bin".
    GP6 is driven low in the first instructions after the imports. An undriven
    pin floats, and a digital servo (5 us dead band) chases that noise instead
    of sitting still --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
    [main.py, servo_jog.py]
2026-09-24 Dataset views, quarantine triage, and a real presence gate in the sorter
    data/raw holds the finest labels ever assigned and must stay append-only;
    changing the training class set by renaming folders there destroys that
    work. So config gains dataset.views: ordered [glob, target] rules that
    project raw folders onto a class set, materialised by build_trainset.py as
    symlinks under data/processed/<view>/. Views cost nothing to build or throw
    away, and --dry-run prints the alphabetical classifier.labels, which is the
    class order YOLO-cls assigns and is silent when wrong.
    Two views: `denomination` folds everything up to dime/nickel/penny (and
    rescues the 123 side-less nickel/ captures that no fine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
    [build_trainset.py, config.yaml, sorter.py, triage_quarantine.py]
2026-09-24 SORT aims only; add bench-test flags for timing runs
    The sorter never started the belt, and SORT halted any free-run before a
    blocking 400-step move (a finite move and RUN cannot share PUL). Belt not
    moving meant no coin crossed the trip line, meant no SORT, meant the belt
    never moved -- the first run would have sat there doing nothing.
    So SORT_ADVANCES_BELT = False: with the belt free-running, the Pi gates on
    coins crossing the trip line and SORT only aims the diverter. --belt-hz
    starts the free-run from the sorter.
    Three flags make the mechanical side testable before a model exists:
    --force-bin ignores the classifier so a run is purely a transport test,
    --no-sort runs the whole perceptio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
2026-09-24 build_trainset: emit train/ and val/ so ultralytics can read the view
    Ultralytics classification requires <root>/train/<class>/ and
    <root>/val/<class>/; check_cls_dataset raises without them. Both this script
    and the Colab notebook were handing it a bare folder-per-class tree, so no
    training run could ever have completed -- consistent with models/ being empty.
    The split belongs in the view, since the view *is* the training layout. It is
    stratified per class and seeded from dataset.train_frac / dataset.seed, so
    every class keeps its ratio and reruns stay comparable. The dry run reports
    the split and flags classes whose val slice is too small to mean anything.
    Also flattens "/" in source lab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
    [build_trainset.py]
2026-09-24 Train on the Jetson Orin Nano in a verified container
    The Orin Nano trains this dataset in ~200s, which beats uploading 194 MB to
    Colab, and it is free. But the environment has five separate traps, each only
    visible once the previous one is fixed:
    - torch cannot be pip-installed on a Jetson. PyPI wheels are x86 or CPU-only
    and ultralytics will quietly pull one, then train at a fraction of speed
    with no error at all. Hence an l4t-pytorch base image.
    - that image pins PIP_INDEX_URL to jetson.webredirect.org, the old
    jetson-ai-lab mirror, which no longer resolves. It is an env var, so it
    overrides every pip.conf and PyPI is never consulted.
    - ultralytics' dependency tree would replace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
    [train.py]
2026-09-24 sorter: schedule diverts for arrival instead of aiming on detection
    The camera's trip line is ~240 mm upstream of the roller nose. At 550 Hz the
    belt runs ~7.9 mm/s, so a coin takes ~30 s to get there, and a live run fed by
    hand at ~2 s intervals had roughly 15 coins in flight at once.
    The loop aimed the dish the moment it classified. By the time the first coin
    reached the nose the dish had been re-aimed fourteen times for coins still
    upstream, so every coin landed in whichever bin the NEWEST coin asked for.
    Every coin after the first is mis-sorted, and nothing in the logs says so.
    DivertQueue holds coins between the trip line and the nose: a decision is
    scheduled for that coin's own arriv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
2026-09-24 sorter: lead the divert, and park the dish at neutral between coins
    Two changes from watching a live sorting run.
    The dish was arriving with the coin instead of ahead of it, so aim
    divert_lead_s (0.75 s) early. It has to be SETTLED when the coin tips off,
    not still slewing; the lead covers servo travel plus belt-speed drift over
    the ~15 s transport. Kept separate from transport_delay_s so the measured
    number stays a measurement and the tuning stays tuning.
    After a coin has cleared, return to neutral_bin (common, straight ahead).
    That is the right resting position because it is the default discard: a coin
    the gate missed, or a double-feed, then falls to the default bin instead of
    into which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
    [config.yaml, sorter.py]
2026-09-24 build_trainset: cap classes, and add a nickels view
    The nickels view is the first one that answers the question the machine
    exists for -- is this one worth keeping -- rather than just naming the
    denomination. Three classes matching three bins, so the confidence threshold
    alone produces the "cannot tell" case.
    buffalo/liberty/shield fold into nickel_keeper, jefferson into
    nickel_common, and pennies/dimes/quarantine into reject so feeding a
    non-nickel lands it in `check` instead of forcing it into a nickel class.
    obv/rev are collapsed because every nickel design here reads from BOTH sides
    (Buffalo's bison, Liberty's V, Jefferson's Monticello), which doubles the
    images per class. That is NOT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
2026-09-24 webcal: sort from the UI, and fix two dedup/label bugs it exposed
    Sorting now runs inside webcal's camera thread rather than as a separate
    process. webcal already owns the camera and the Pico, so the CLI sorter had
    to fight it for both -- you could calibrate or sort, never both, and
    changing which cup a class goes to meant editing YAML and restarting.
    The UI gains a panel: start/stop, a left/centre/right button per class the
    loaded model actually emits, and a live tally with an in-flight count. The
    map is seeded from sorter.sort_map and applies immediately. Classes are
    shown by cup position because that is what you see standing at the machine;
    the firmware still knows them by name. An unmap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
    [webcal.py]
2026-09-25 Add a dimes_fine view, and actually disable pin_memory on the Jetson
    dimes_fine is one class per design, like pennies_fine: roosevelt, mercury,
    barber_obv, seated_obv, and dime_wreath_rev. The Barber and Seated reverses
    share a class because Barber dimes reused the Seated 1860-91 wreath reverse
    unchanged; both are silver keepers, so merging them costs nothing at sort
    time. Val 120/120, all at or above 0.90 -- but the split is by image, so the
    same coin sits in train and val, and seated_obv/barber_obv are 12 and 18
    images.
    The first dimes run died with "CUDA error: out of memory" in the pin-memory
    thread. ultralytics 8.3.x no longer reads a PIN_MEMORY env var:
    build_dataloader takes pin_memo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
    [config.yaml, train.py]
2026-09-25 Add pennies and pennies_fine views
    pennies_fine is one class per design (memorial, shield, wheat, indian,
    steel), with the keep/reject grouping left to the sorting panel so hunting a
    different variety is a UI change, not a retrain. pennies bakes the same
    designs into keeper/common for comparison.
    Both give the Lincoln obverse its own class, penny_obverse: wheat, memorial
    and shield cents share it and differ only by the date, about 10 px at imgsz
    224. That is an honest "cannot tell" that routes to the re-feed pile, where
    the coin eventually lands reverse-up. penny_wheat_obv folds in there too
    rather than teaching the model to read dates it cannot resolve.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
    [config.yaml]
2026-09-25 Hold the dish on target longer, and let config set how long
    The dish was letting go about half a second too soon. It is on target from
    (arrival - divert_lead_s) until neutral_after_s after aiming, so the late
    tolerance is neutral_after_s - divert_lead_s: with 1.0 and a 0.75 s lead, a
    coin only 0.25 s late found the dish back at centre and landed in the re-feed
    pile -- which looked like "it moved too early" and was really "it let go too
    soon". neutral_after_s is now 1.75, a full second of late tolerance.
    webcal had 1.0 hard-coded in the park-at-neutral check and ignored
    sorter.neutral_after_s entirely; it now reads it from config.
    [config.yaml, webcal.py]
2026-09-25 webcal: pick the sorting model from the UI, and trust its embedded labels
    The sort panel gets a dropdown listing every .onnx in the models dir with its
    class count. Switching reloads the classifier and reseeds the bin map for the
    new classes: *_keeper -> keep, *_common -> reject, everything else (including
    the deliberately undecidable penny_obverse) -> the re-feed pile. Assignments
    survive a switch where the class name still exists, so flipping between models
    does not lose a mapping you just set. /setmodel only opens files that
    /models listed, since the path comes from the browser.
    This only works because CoinClassifier now takes class names from the ONNX
    metadata that ultralytics writes. T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
    [infer.py, webcal.py]
2026-09-27 coin_hat rev 1: servo diverter on its own buck, board runs lengthwise
    The diverter is now the MG996R servo, not a stepper: drop the third
    StepStick socket, its jumpers, motor connector and home switch, and add
    a separate 12V->5-6V buck (U8) for a +SERVO rail, a 3-pin servo header
    on GP6 (driven directly), 1000uF at the connector, a rail-live LED and
    a GP27 rail sense. A dead servo rail with GP6 pulsing back-powers the
    servo through its signal pin and looks like a signal fault.
    The outline now runs along the Pi: 109 x 56.5, with a 44 mm overhang
    past the SD end instead of 33.5 mm off the header edge. It also fixes
    two rev 0 errors against the HAT+ spec: the header was 1.27 mm off in
    both axe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
    [coin_hat.kicad_pcb, coin_hat.kicad_sch]
2026-09-27 coin_hat: fix diode polarity and StepStick pinout, size board to fit
    Checked with KiCad 9 (ERC, DRC, symbol pin vs footprint pad). Three
    pin-numbering bugs carried over from rev 0 would have shipped broken:
    - Diode symbols had the anode on pin 1; KiCad footprints put the
    cathode there. D3/D4 flybacks would short 12V to ground when the key
    light or aux output switched on, D1 would block the Pico's VSYS and
    the servo-rail LED would never light.
    - The StepStick symbol numbered pins 1=EN..16=GND, but the
    Pololu_Breakout-16 footprint is 1=GND..16=DIR, so every driver pin,
    VMOT included, landed on the wrong pad.
    - Neither Pololu buck matches the generic 1x5 footprint used for U5/U8
    (D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
    [coin_hat.kicad_pcb, coin_hat.kicad_sch]
2026-09-27 coin_hat: draw Pololu buck footprints from the drill guides
    U5 and U8 were a generic 1x5 header that matched neither module. Add a
    project footprint library (coin_hat.pretty + fp-lib-table) with
    Pololu_D24V50F5 and Pololu_D36V28Fx, placing pads and #2 mounting holes
    at the coordinates in Pololu's drill-guide DXFs (reg15d01, reg24g), top
    view, pad 1 = EN:
    D24V50F5 EN VIN GND GND VOUT
    D36V28Fx EN VIN GND GND VOUT, PG 0.1" inboard of EN
    Replace the generic Buck symbol with one symbol per module. EN is left
    open (100k pull-up to VIN on both modules) and PG is unused. ERC is
    clean, every pin maps to a pad, and the floor plan still packs with the
    real 18.4 x 20.9 courtyards.
    Co-Authored-B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
    [coin_hat.kicad_pcb, coin_hat.kicad_sch]
2026-09-27 coin_hat: update PCB from schematic and place all footprints
    Pull all 56 footprints into the board with their nets and symbol links
    (so a GUI Update PCB matches them instead of duplicating), and place
    them on the checked floor plan: J1 on the bottom with pin 1 at the
    HAT+ position (8.37, 4.77), Pico with USB toward the open +x side,
    connectors, fuse and jack on the overhang end.
    DRC fixes along the way: move the left-end column up so the jack's
    switch pin clears the 0.5 mm edge rule, tighten the two overhang-end
    corners to 1 mm so J2/J5 don't overhang the radius, move edge-clipped
    reference labels onto their parts, and mark the solder jumpers
    not-in-BOM to match their footprints.
    DRC: 0 er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
    [coin_hat.kicad_pcb, coin_hat.kicad_sch]
2026-09-27 coin_hat: route the board and generate JLCPCB / PCBWay files
    Fully routed 2-layer board, KiCad 9 DRC clean (0 violations, 0
    unconnected, 0 schematic-parity issues). Freerouting did the bulk; the
    Pi 5V feed to J1 pins 2/4 is hand-placed and locked (1.5 mm, necking to
    1.0 mm past the mounting hole). Net classes for high-current, power,
    motor and ground nets, GND poured on both layers, and copper keepouts
    under the HAT+ standoffs (3.1 mm bottom, 2.6 mm top).
    Placement changes to make it route: driver column 1 mm right, Pico and
    its neighbours 1.5 mm down, gate resistors spread out. J5 becomes the
    CUI PJ-102AH footprint (same pad pattern, 5 A rated).
    Schematic symbols now carry LCSC / Manufact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
    [coin_hat.kicad_pcb, coin_hat.kicad_sch, coin_hat_bom_jlcpcb.csv, coin_hat_bom_pcbway.csv, coin_hat_centroid_pcbway.csv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]
2026-09-27 coin_hat: track the Gerber zip (exempt fab/ from the *.zip ignore)
    Claude-Session: https://claude.ai/code/session_01EPngbBgcoS7WRgtdrApT7C
2026-09-27 coin_hat: pre-fab review fixes
    - Move the Pico so its micro-USB socket is at the board edge; 9 mm of
    board sat in the footprint's USB-cable keepout and would have blocked
    the plug used for REPL / mpremote.
    - Add 100 nF bypass caps C7 (U6 level shifter) and C8 (U7 HAT+ EEPROM),
    JLCPCB basic part C14663.
    - Power-net vias 1.2/0.6 mm (~3 A); the switched outputs and the TVS
    each went through a single 0.4 mm via. One AUX_SW via stays 0.8/0.4
    for clearance, so J12 is rated ~1.5 A.
    - Remove paste from the Pico pads (not fab-assembled).
    - Move the EEPROM group into the pocket left of the Pico; the board now
    routes completely.
    KiCad 9: ERC 0 errors, DRC 0 errors / 0 unconnected / 0 parit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
    [coin_hat.kicad_pcb, coin_hat.kicad_sch, coin_hat_bom_jlcpcb.csv, coin_hat_bom_pcbway.csv, coin_hat_centroid_pcbway.csv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]
